raymirabel/MB-4AR_MODBUS/README.md

# MB4AR_MODBUS
Módulo 4 salidas/entradas analógicas, 4 salidas relés, puerto RS485
