raymirabel/MB-4AR_MODBUS/MANUAL MB4AR v1_01.pdf

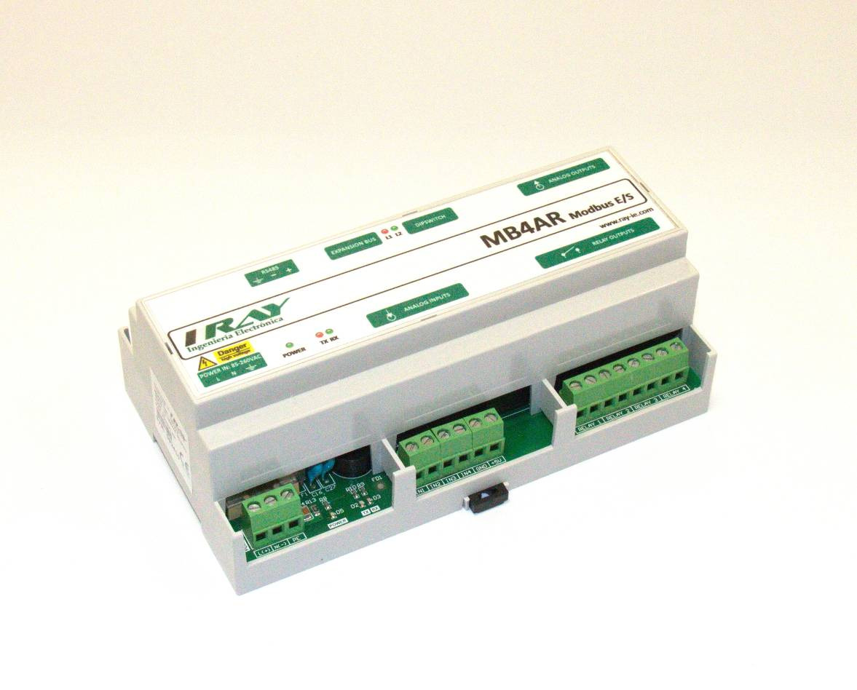
[picture p1: figure]

1

C/Paso a nivel s/n
10540 Mirabel – Cáceres
Telf. 927 45 01 38
www.ray-ie.com | MB4AR v1.00
Versión: | V1.01 | Elaborado por: | Revisado por:
Fecha validez: | 26/01/2017 | Raimundo Alfonso Sánchez | Raimundo Alfonso Sánchez

MANUAL DESCRIPCION MB4AR v1_01.doc

# MB4AR v1.00

REF. 141212 - V1.01

2

Telf. 927 45 01 38
www.ray-ie.com | MB4AR v1.00
Versión: | V1.01 | Elaborado por: | Revisado por:
Fecha validez: | 26/01/2017 | Raimundo Alfonso Sánchez | Raimundo Alfonso Sánchez

ÍNDICE DE CONTENIDO

3

Telf. 927 45 01 38
www.ray-ie.com | MB4AR v1.00
Versión: | V1.01 | Elaborado por: | Revisado por:
Fecha validez: | 26/01/2017 | Raimundo Alfonso Sánchez | Raimundo Alfonso Sánchez
1. Características generales.
- | CPU: | Atmega328P
- | Compatibilidad Arduino: | Arduino Diecimilla 328
- | Frecuencia operación: | 16Mhz
- | FLASH: | 32K
- | RAM: | 2Kb
- | Alimentación: | 90 - 264VAC o 6.5 - 30 VDC (según
| modelo)
- | Salidas relés: | 4 (5A. cada una)
- | Entradas digitales/analógicas: | 4 (5V o 10V o 0/20mA seleccionable)
- | Salidas analógicas: | 4 (5V o 10V)
- | Dipswitch: | 6 posiciones propósito genera
- | Leds auxiliares: | 2
- | Conector auxiliar I2C: | RJ12 compatible ArduPLC
- Zócalo para RTC
- Puerto RS485 aislado
- Buzzer

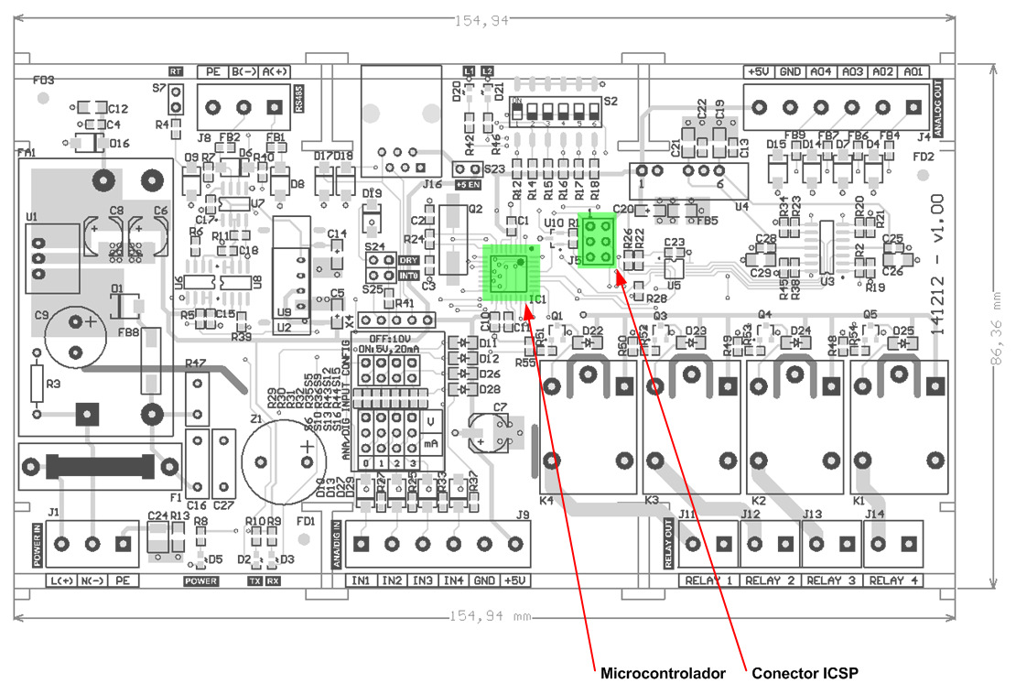
[picture p2: figure]

4

Telf. 927 45 01 38
www.ray-ie.com | MB4AR v1.00
Versión: | V1.01 | Elaborado por: | Revisado por:
Fecha validez: | 26/01/2017 | Raimundo Alfonso Sánchez | Raimundo Alfonso Sánchez
2. Microcontrolador.

Especificaciones del microcontrolador:

- | CPU: | Atmega328P
- | Frecuencia operación: | 16Mhz
- | FLASH: | 32K
- | RAM: | 2Kb

5

Telf. 927 45 01 38
www.ray-ie.com | MB4AR v1.00

Versión:

Fecha validez:

V1.01

26/01/2017

Elaborado por: | Revisado por:
Raimundo Alfonso Sánchez | Raimundo Alfonso Sánchez

Resumen pines de funciones:

PIN ARDUINO DIECIMILLA | FUNCION
0 | RS485 - RX
1 | RS485 - TX
2 | LDAC
3 | DREADY/INT0
4 | DIPSWITCH 1
5 | DIPSWITCH 2
6 | DIPSWITCH 3
7 | RELE 1
8 | RELE 2
9 | RELE 3
10 | RELE 4
11 - MOSI | DIPSWITCH 4
12 - MISO | LED 2
13 - SCK | LED 1/BUZZER
A0/14 | AN0/DIG0
A1/15 | AN0/DIG1
A2/16 | AN0/DIG2
A3/17 | AN0/DIG3
A4 | I2C - SDA
A5 | I2C - SCL
A6 | DIPSWITCH 5
A7 | DIPSWITCH 6

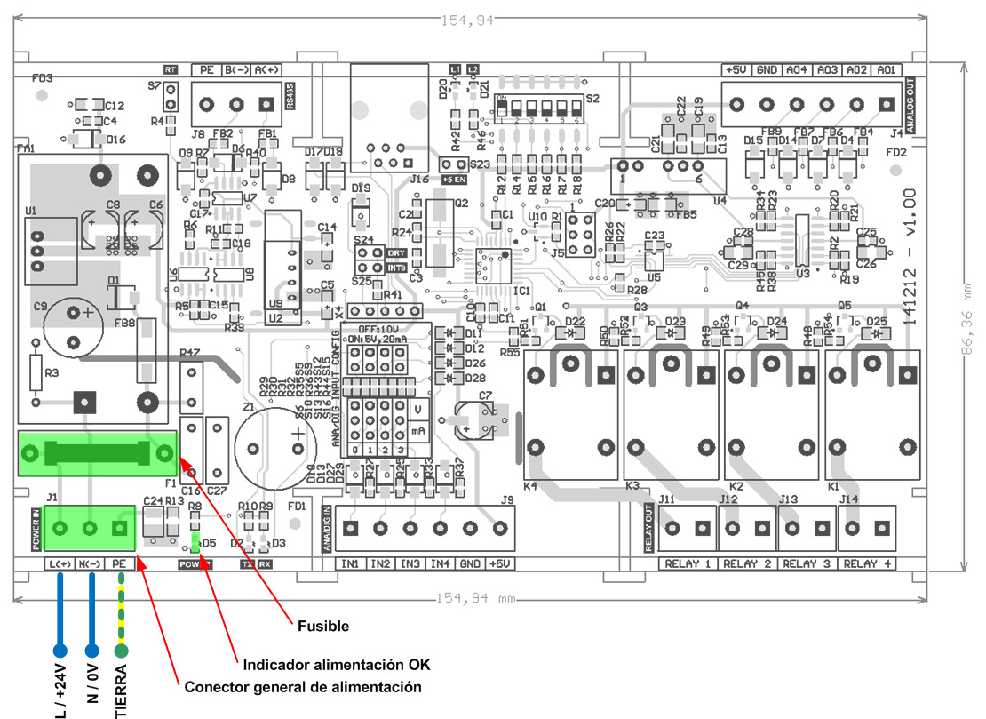
[picture p3: figure]

6

Telf. 927 45 01 38
www.ray-ie.com | MB4AR v1.00
Versión: | V1.01 | Elaborado por: | Revisado por:
Fecha validez: | 26/01/2017 | Raimundo Alfonso Sánchez | Raimundo Alfonso Sánchez
3. Alimentación.

Según el modelo, existen dos tipos de entrada de alimentación: DC o AC (alto voltaje)

Especificaciones de alimentación DC:

- | Tensión de alimentación nominal: | 24 VDC
- | Tensión de alimentación admisible: | 6.5 - 30 VDC
- | Consumo máximo: | 2W
- | Fusible: | 1A - 20x5mm
- Protección contra inversión de polaridad

7

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

Especificaciones de alimentación AC o alto voltaje:

- | Tensión de alimentación nominal: | 230VAC
- | Tensión de alimentación admisible: | 85 - 264VAC / 47-440Hz 120 - 370VDC
- | Consumo máximo: | 10W
- | Fusible: | 1A - 20x5mm

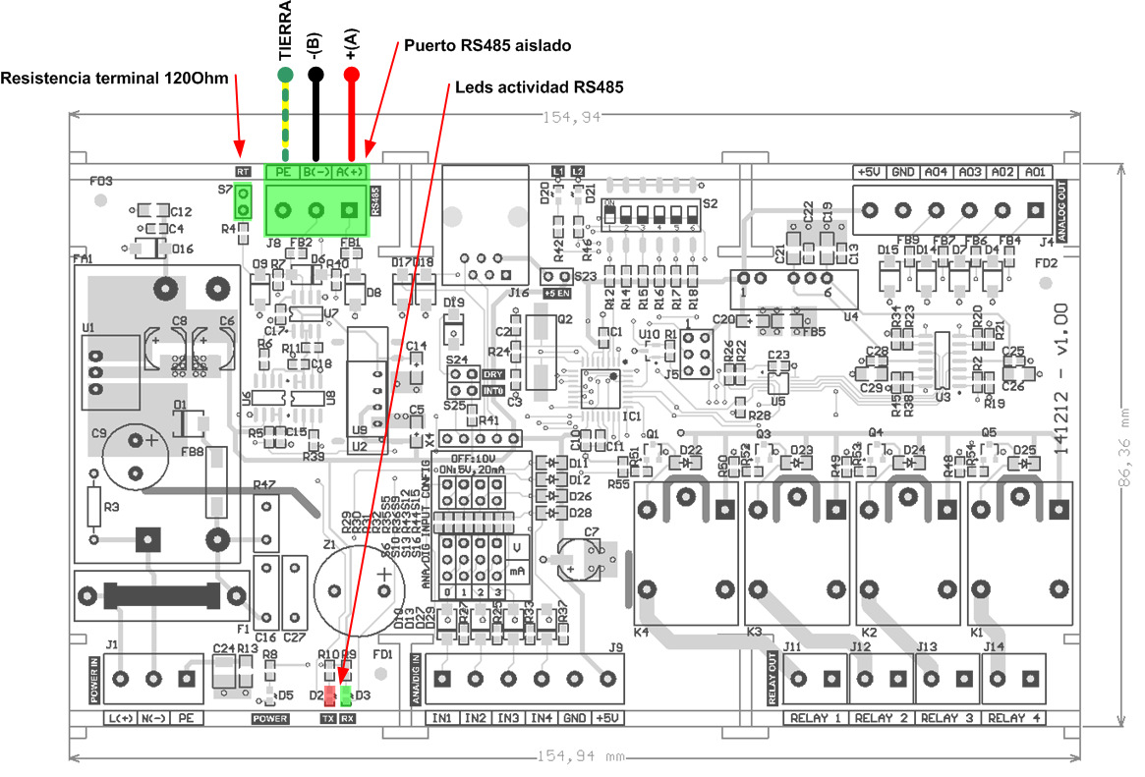
[picture p4: figure]

8

Telf. 927 45 01 38
www.ray-ie.com | MB4AR v1.00
Versión: | V1.01 | Elaborado por: | Revisado por:
Fecha validez: | 26/01/2017 | Raimundo Alfonso Sánchez | Raimundo Alfonso Sánchez
4. Puerto RS485.

Especificaciones RS485 aislado:

- Velocidad máxima de 500 Kbps
- Protección ESD +/- 15Kv
- Control de dirección de flujo automática
- Soporta ¼ de carga unitaria o 128 dispositivos en red
- Aislamiento galvánico 3000v
- Puerto serie microcontrolador: UART0

El driver encargado de gestionar el puerto RS485 es el chip MAX13487 de Maxim. Este incorpora un mecanismo especial capaz de gestionar

9

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

automáticamente el sentido de flujo de datos. Para tal efecto, el chip necesita polarizar el bus RS485 mediante dos resistencias. En la totalidad del bus solo es suficiente con polarizar un extremo o nodo de la red.

Para ello, en la parte trasera de la placa hay dos jumpers soldables para activar o desactivar las resistencias de polarización del bus: S1 y S3.

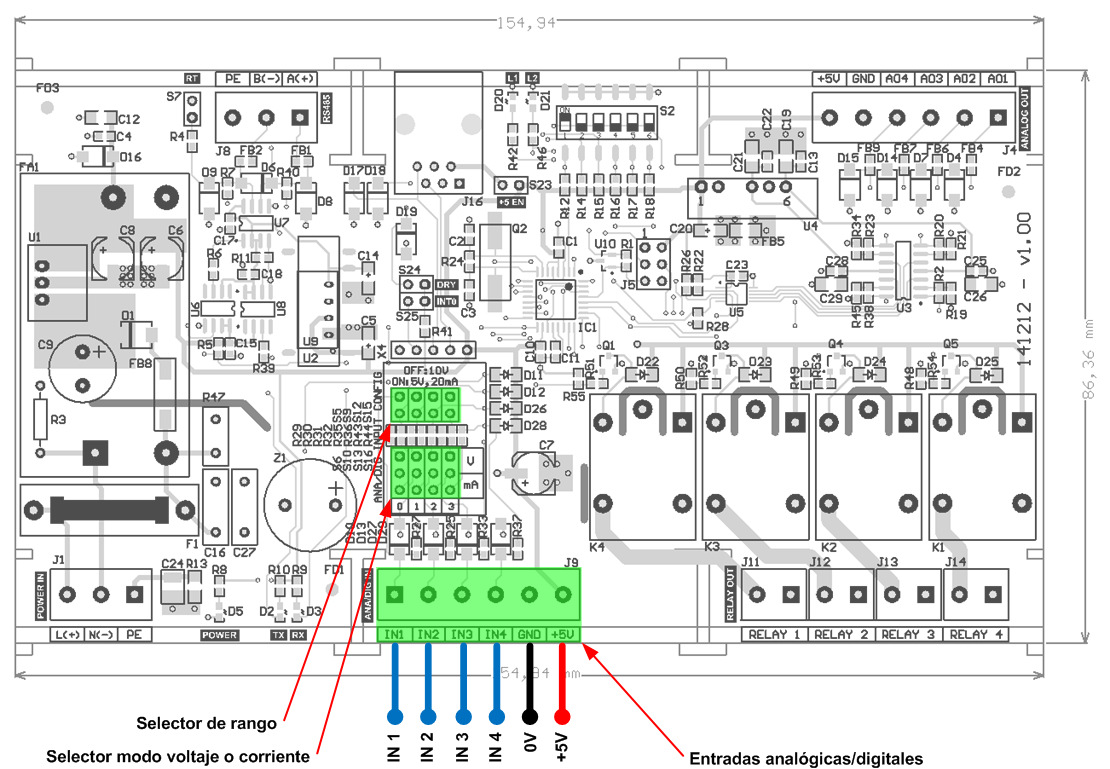
[picture p5: figure]

10

Telf. 927 45 01 38
www.ray-ie.com | MB4AR v1.00

Versión:

Fecha validez:

V1.01

26/01/2017

Elaborado por: | Revisado por:
Raimundo Alfonso Sánchez | Raimundo Alfonso Sánchez
5. Entradas analógicas/digitales.

Disponemos de 4 entradas analógicas configurables mediante jumpers. Estas entradas analógicas también pueden ser usadas como entradas digitales.

ENTRADAS ANA/DIG | PIN ARDUINO
IN1 | A0/14
IN2 | A1/15
IN3 | A2/16
IN4 | A3/17

11

Telf. 927 45 01 38
www.ray-ie.com | MB4AR v1.00

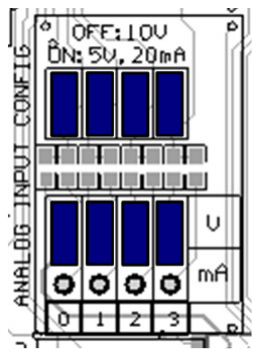
[picture p6: figure]
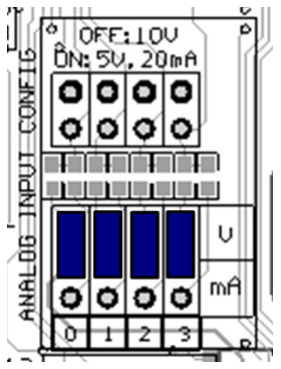
[picture p7: figure]
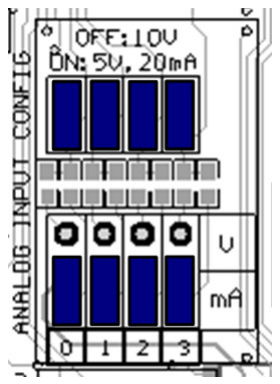
[picture p8: figure]
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

Podemos configurar cada entrada, de forma independiente, como entrada de 5V, 10V o 0/20mA:

Para configurar las entradas como 0/5V:

Para configurar las entradas como 0/10V (configuración por defecto):

Para configurar las entradas como 0/20mA:

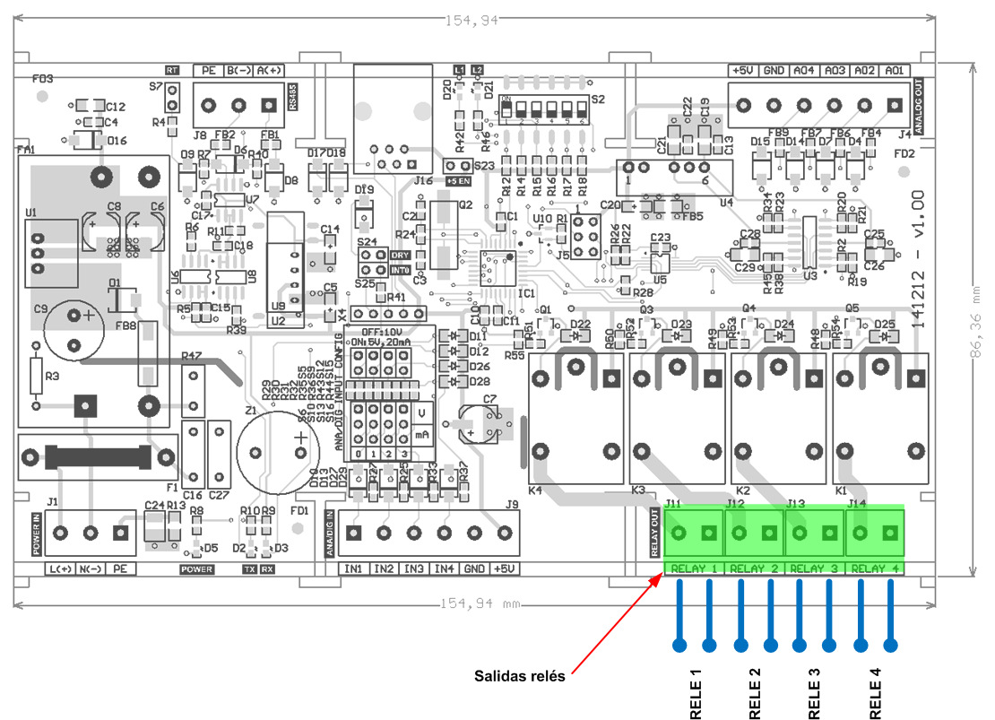
[picture p9: figure]

12

Telf. 927 45 01 38
www.ray-ie.com | MB4AR v1.00

Versión:

Fecha validez:

V1.01

26/01/2017

Elaborado por: | Revisado por:
Raimundo Alfonso Sánchez | Raimundo Alfonso Sánchez
6. Salidas relé.
SALIDA RELES | PIN ARDUINO
RELE 1 | 7
RELE 2 | 8
RELE 3 | 9
RELE 4 | 10

13

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

Especificaciones salida relé:

- | Máxima corriente: | 5A
- | Máxima tensión: | 250VAC o 30VDC
- | Máxima potencia: | 2500VA, 300W
- Resistencia del contacto: 100mOhm
- | Vida eléctrica: | 100,000 operaciones a 10A y 250VAC
- | Vida mecánica: | 10,000,000 operaciones

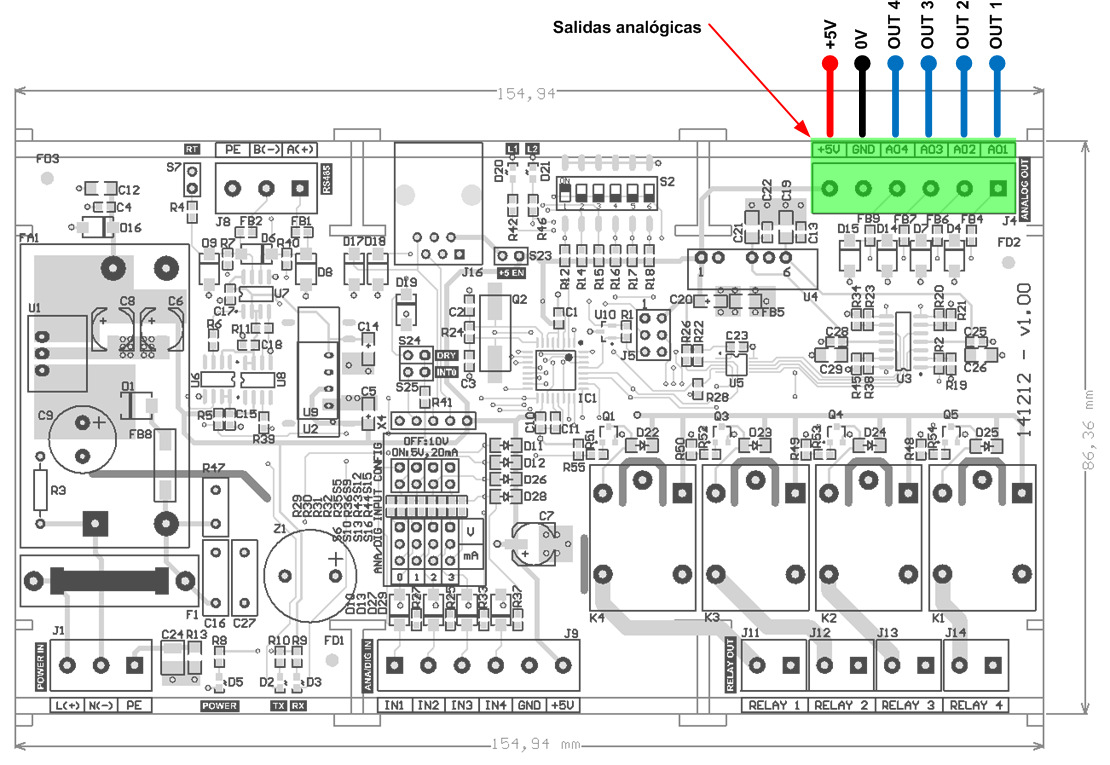
[picture p10: figure]

14

Telf. 927 45 01 38
www.ray-ie.com | MB4AR v1.00
Versión: | V1.01 | Elaborado por: | Revisado por:
Fecha validez: | 26/01/2017 | Raimundo Alfonso Sánchez | Raimundo Alfonso Sánchez
7. Salidas analógicas.

Disponemos de 4 salidas analógicas de programables entre 0v y 10v. Las salidas analógicas son gestionadas por el convertidor DAC MCP4728 de Microchip a través del puerto I2C.

Especificaciones salidas analógicas:

- | Rango de salida: | 0/10V
- | Resolución: | 12 bits
- | Corriente máxima por salida | 10mA

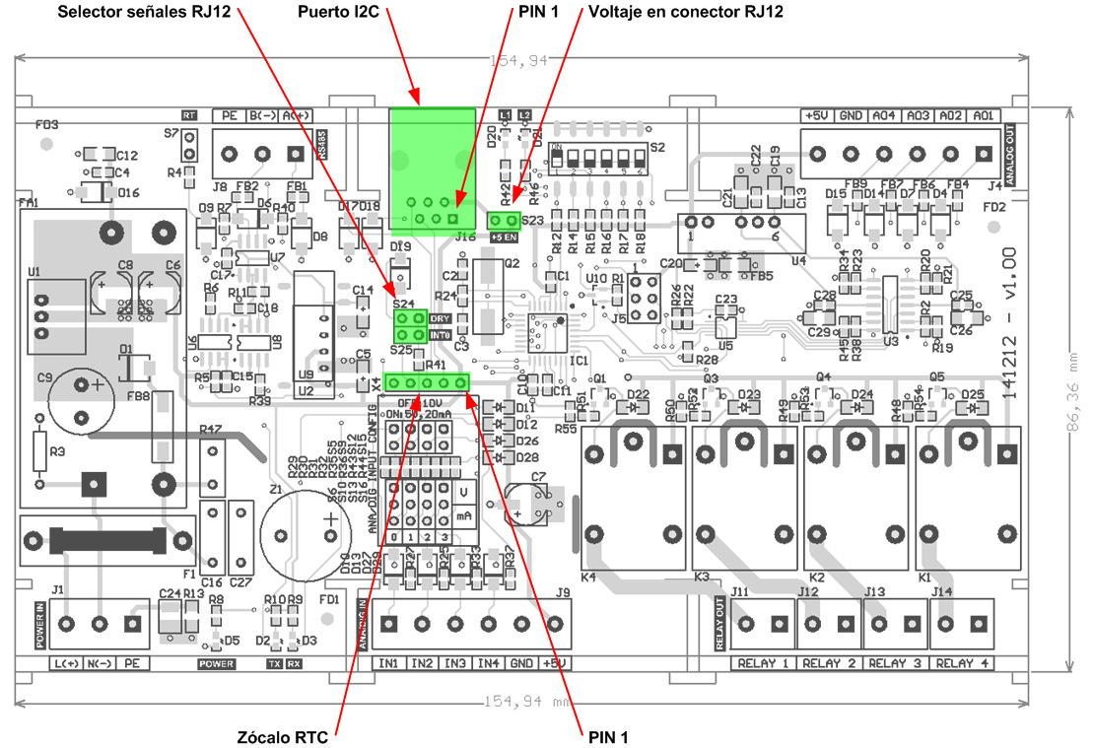
[picture p11: figure]

15

Telf. 927 45 01 38
www.ray-ie.com | MB4AR v1.00

Versión:

Fecha validez:

V1.01

26/01/2017

Elaborado por: | Revisado por:
Raimundo Alfonso Sánchez | Raimundo Alfonso Sánchez
8. Puerto I2C - RJ12 y zócalo RTC.

Para desactivar los 5VDC del conector RJ12 quite el Jumper S23.

El pinout del conector BUS I2C (RJ12 6/6) es el siguiente:

PIN RJ12 | SEÑAL
1 | +24VDC (*)
2 | +5VDC
3 | GND
4 | DREADY
5 | SCL
6 | SDA

16

Telf. 927 45 01 38
www.ray-ie.com | MB4AR v1.00

Versión:

Fecha validez:

V1.01

26/01/2017

Elaborado por: | Revisado por:
Raimundo Alfonso Sánchez | Raimundo Alfonso Sánchez

(*) NOTA: no disponible en este diseño

El pinout del zócalo para el módulo RTC es el siguiente:

PIN RTC | SEÑAL
1 | +5VDC
2 | SCL
3 | SDA
4 | INT
5 | 0V

Las señales INT y DREADY se comparten el pin 3 de arduino por lo que solo puede usarse una de ellas. Seleccione con los jumpers S24 o S25 la señal que desee.

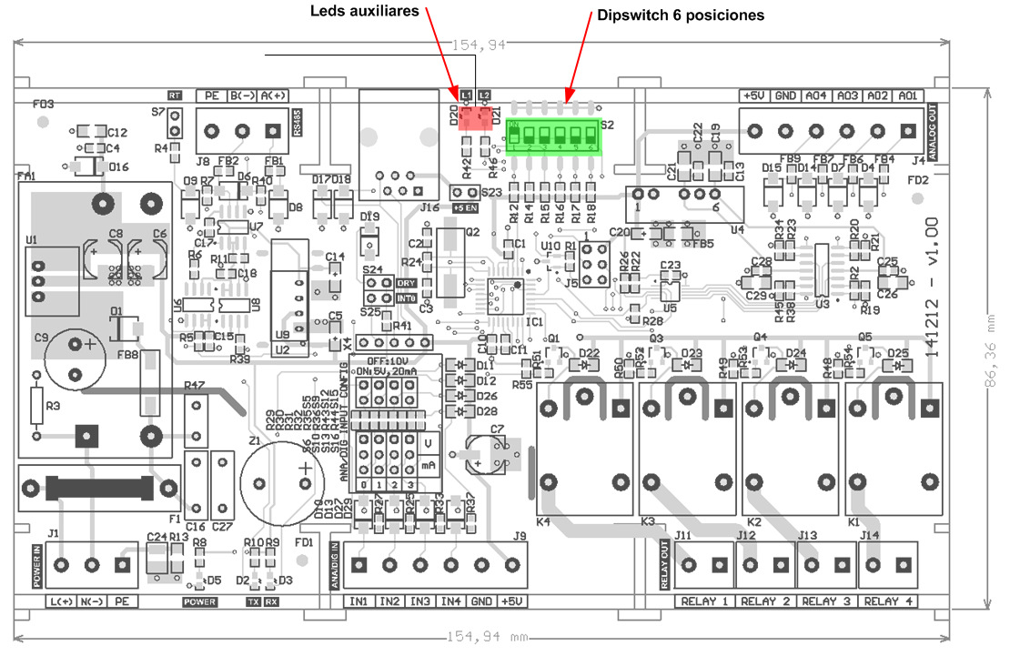
[picture p12: figure]

17

Telf. 927 45 01 38
www.ray-ie.com | MB4AR v1.00

Versión:

Fecha validez:

V1.01

26/01/2017

Elaborado por: | Revisado por:
Raimundo Alfonso Sánchez | Raimundo Alfonso Sánchez
9. Dipswitch y leds auxiliares.

Disponemos de un dipswitch de 6 posiciones y 2 leds para propósito general.

DIPSWITCH - LEDS | PIN ARDUINO
DIPSWITCH, POS 1 | 4
DIPSWITCH, POS 2 | 5
DIPSWITCH, POS 3 | 6
DIPSWITCH, POS 4 | 11 o MOSI
DIPSWITCH, POS 5 | A6 (*)
DIPSWITCH, POS 6 | A7 (*)
LED 2 | 12 o MISO
LED 1 | 13 o SCK (o BUZZER)

(*) NOTA: para leer valor, es necesario leer como entrada analógica.

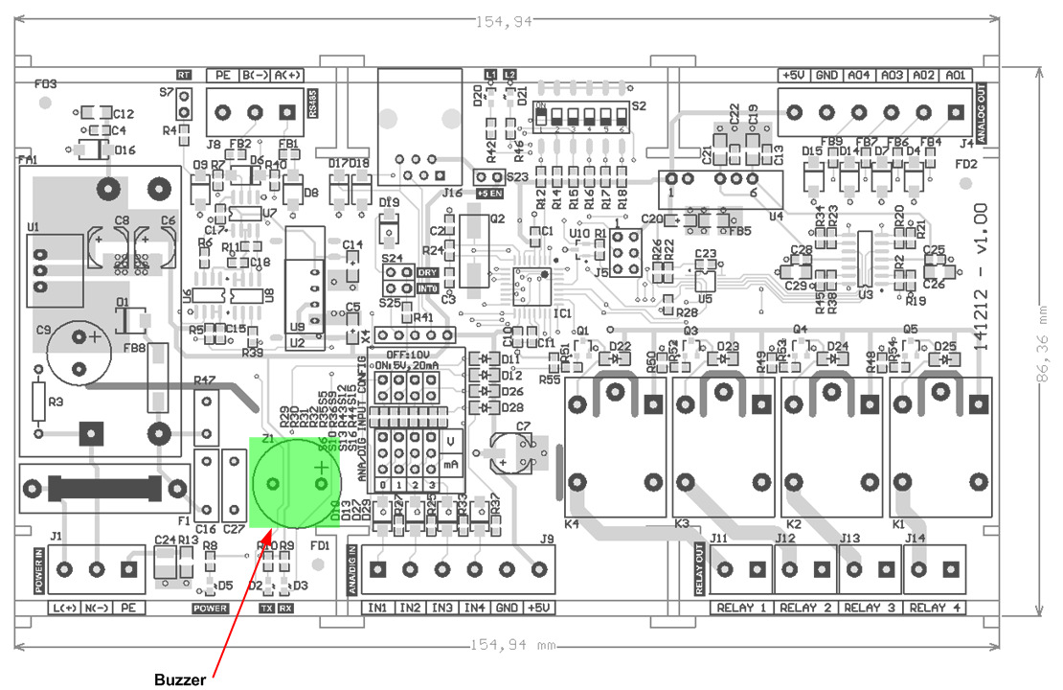
[picture p13: figure]

18

Telf. 927 45 01 38
www.ray-ie.com | MB4AR v1.00

Versión:

Fecha validez:

V1.01

26/01/2017

Elaborado por: | Revisado por:
Raimundo Alfonso Sánchez | Raimundo Alfonso Sánchez

10.Buzzer.

SEÑAL | PIN ARDUINO MEGA
BUZZER (también LED 1) | 13 o SCK

Para activar el buzzer es necesario activar el jumper soldable localizado en la parte posterior de la placa.

El buzzer se comparte con el LED 1.

19

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

11.Modbus.

Por defecto, el módulo MB4AR trae el firmware modbus cargado.
La configuración queda de la siguiente forma: 9600, n, 8, 1
La dirección modbus se establece mediante el dipswitch de 6 posiciones, lo cual nos permite hasta 63 direcciones posibles.

El mapa modbus es el siguiente:

MODO R: FUNCION 1 - READ BLOCK COILS REGISTERS (dirección coil = dirección * 16) MODO R: FUNCION 3 - READ BLOCK HOLDING REGISTERS
MODO W: FUNCION 6 - WRITE SINGLE HOLDING REGISTER
DIRECCION | TIPO | MODO | FORMATO | MAXIMO | MINIMO | UNIDADES | DESCRIPCION
0x0000 | int | R | 00000 | 01023 | 00000 | --- | Entrada analógica 1
0x0001 | int | R | 00000 | 01023 | 00000 | --- | Entrada analógica 2
0x0002 | int | R | 00000 | 01023 | 00000 | --- | Entrada analógica 3
0x0003 | int | R | 00000 | 01023 | 00000 | --- | Entrada analógica 4
0x0004 | int | R | 00000 | 00015 | 00000 | --- | (reservado)
0x0005 | int | R/W | 00000 | 00015 | 00000 | --- | Salidas relés en formato
| | | | | | | binario
0x0006 | int | R | 00000 | 00063 | 00000 | --- | Dirección modbus o estado
| | | | | | | del dipswitch
0x0007 | int | R/W | 00000 | 04095 | 00000 | --- | Salida analógica 1
0x0008 | int | R/W | 00000 | 04095 | 00000 | --- | Salida analógica 2
0x0009 | int | R/W | 00000 | 04095 | 00000 | --- | Salida analógica 3
0x000A | int | R/W | 00000 | 04095 | 00000 | --- | Salida analógica 4
0x000B | int | R | 00000 | 00015 | 00000 | --- | Entradas analógicas como
| | | | | | | digitales y en formato
| | | | | | | binario
