raymirabel/MB-4AR_MODBUS/(commit log)

2015-09-28 Revert "s"
    This reverts commit 3931dd4a2e8dc16c2645cebe21395e5082bb8142.
    [MB4AR_Modbus.ino]
2015-09-28 Revert "Revert "s""
    This reverts commit c646d8d4c651ceeadd529183c0c8d1380f472261.
    [MB4AR_Modbus.ino]
